FranzVanChopin/ac920-score-digitizer/requirements-board.lock.txt

# Version record from the frozen board Python 3.12 environment.
# ARM64 wheels and Ubuntu system GTK packages are installed separately; see docs/BUILD.md.
antlr4-python3-runtime==4.9.3
certifi==2026.7.22
charset-normalizer==3.5.2
colorlog==6.12.0
flatbuffers==25.12.19
homr==0.7.0
idna==3.20
mido==1.3.3
musicxml==1.4
numpy==2.5.3
omegaconf==2.3.1
onnxruntime==1.30.0
opencv-python-headless==4.14.0.94
packaging==26.3
pillow==12.3.0
pip==25.0.1
protobuf==7.36.2
pyclipper==1.4.0
PyYAML==6.0.3
rapidocr==3.10.0
requests==2.34.2
shapely==2.2.0
six==1.17.0
tqdm==4.70.1
types-Pillow==10.2.0.20240822
typing_extensions==4.16.0
urllib3==2.8.0
verovio==6.3.0
