FranzVanChopin/ac920-score-digitizer/board/recognition/EVIDENCE_20261103.md

# 证据包说明（2026-11-03）

来源：`AC920_Handoff_Evidence_20261103`，对应源码包 `AC920_Source_GitHub_20261102`。
稳定版 **DP_STABLE720_RESPONSE1 / a4_interactive_ui1_light2**，拍摄端与 Ubuntu 均为 720p60。

## 材料去向

| 材料 | 本仓库位置 |
|---|---|
| 综合 / 实现 timing、utilization、DRC 原报告 | `build/reports/` |
| 2026-10-29 原始报告（未改动） | `build/reports/original_20261029/` |
| 报告导出执行日志（含一次可复核的纠错） | `build/report_export_logs/` |
| 报告身份：工具、时间、检查点/位流/XSA/BOOT 哈希、时序与资源摘要 | `build/reports/REPORT_IDENTITY.json` |
| 本次卡内容回读（只读 FAT） | `board/recognition/card_20261103/` |
| 历史板端识别日志 | `board/recognition/historical/` |
| 机器可读验收摘要 | `board/recognition/VALIDATION_20261103.json` |

## FPGA 报告

用 Vivado 2024.2 从**既有已验收工程与 routed checkpoint 重新导出**，不是重新综合或实现，
位流、XSA、BOOT 与 43 份固件源码均与稳定版构建记录核对过。

| 阶段 | WNS | TNS | WHS | THS | WPWS |
|---|---:|---:|---:|---:|---:|
| synthesis | 1.871 | 0 | −0.447 | −1014.791 | −0.832 |
| implementation | **0.817** | **0** | **0.011** | **0** | **0.145** |

实现后资源：LUT 10,825（12.32%）、寄存器 16,272（9.26%）、BRAM Tile 22.5（17.58%）、URAM 8（16.67%）、DSP 8（1.10%）。
实现 DRC：0 Error、0 Critical Warning，保留 **8 条 Warning**（DPOP-4×4、REQP-1934×1、REQP-1935×2、RTSTAT-10×1）。

**综合阶段尚未布局布线**，其 hold / pulse-width 负裕量不代表实现结果；
验收只看 implementation 报告，两个阶段不可混用。详见 `build/reports/README.md`。

该报告对应**纯 DP 采集工程** `camera_capture_wrapper`（即当前部署设计），不是历史 HDMI 分支。
`REPORT_IDENTITY.json` 里的 checkpoint 路径仍记为导出当时的 `lab/...`；重组后实际位于
`board/camera_onecard_20261029/`。证据内容本身未改写。

## 识别日志

历史日志来自真实开发板执行，含 stable720 第 0 首约 **40.9 s** 的识别、逐阶段耗时与 v16 集成检查。
本次只是**读取回**卡内 FAT，没有触发新识别、没有播放音频、没有改写启动文件。

第 01 首共 **6 页**，逐页小节数为 **17 / 14 / 11 / 6 / 10 / 13**，合计 **71 小节**；
第 00 首 1 页 17 小节。这组数字解释了 `data/samples/result/01.musicxml` 为什么是整首 71 小节，
而样张只有第 1 页（17 小节）。

ext4 内的 service journal 因当时 Windows 进程无原始设备读权限而未取回，详见
`board/recognition/card_20261103/README.md`。

## 未并入的材料

原证据包的 `MANIFEST.json` 列了 **121 项**，实际只交付 **111 项**，缺 10 项；
其自带的 `verify_manifest.py` 因此会失败。本仓库不收录该清单与校验脚本，
统一由根目录 `PACKAGE_MANIFEST.json` 校验。

**这些缺口已由 2026-11-03 的脱敏补充包替代**（见 `REPO_LAYOUT.md` 第 8 节）：
原始聊天摘录、`EXPORT_SCOPE.json`、需求截图与 `README_给组长.md` 按脱敏要求**不再分发**，
改以 `collaboration/` 下的 3 份抽象说明承载分工与纠错方法。
旧清单中缺失的具体项（仅作记录）：`collaboration/` 7 个文件（Codex 三份摘录、
`Claude_visible_messages.md/.json`、`AI_WORKFLOW_AND_CORRECTIONS.md`、`EXPORT_SCOPE.json`）、
`requirements/request_1.png`、`requirements/request_2.png`、`README_给组长.md`。

另：

- 证据包根目录的 3 张 `Screenshot 2026-11-03 *.png` 不在其清单内，且与清单所列
  `requirements/*.png` 不是同一批文件；属需求沟通截图，未并入公开仓库。
- `docs/CAPTURE_INTERFACE.md` 与本仓库 `report/CAPTURE_INTERFACE.md` 字节相同，未重复收录。
- `board/recognition/card_20261103/Outputs/01.musicxml`（CRLF）与
  `data/samples/result/01.musicxml`（LF）**内容相同、字节不同**：前者是脱敏重导出的卡回读快照，
  后者供复现比对。此前记录的「同一 SHA-256」在重导出后不再成立，以本段为准。

完整性与逐文件身份见 `docs/EVIDENCE_PROVENANCE.json`（记录 `source_sha256` 与 `published_sha256`）。
