FranzVanChopin/ac920-score-digitizer/src/omr/docs/lens_compare_README.md

# 镜头与光圈对比（2026-10-29）

样片：`Image/Compare`，同一张乐谱（《月光》第三乐章第 1 页，第 1–21 小节，7 行谱），IMX477 全分辨率灰度 4056×2868（已裁成 A4 比例），增益 0。

| 照片 | 镜头 | 光圈 | 曝光 |
|---|---|---|---|
| 1 | 8 mm | F2.8 | 92 ms |
| 2 | 8 mm | F4 | 222 ms |
| 3 | 12 mm | F2.4 | 63 ms |
| 4 | 12 mm | F4 | 172 ms |
| 5 | 16 mm | F2.4 | 59 ms |
| 6 | 16 mm | F4 | 185 ms |

照片是横向的，先逆时针旋转 90° 摆正后再评估（识别端不会自动旋转）。

## 结论

1. **光圈用 F2.4–F2.8，不要收到 F4。** 这个距离下，F2.4 的景深已有约 35 mm，平放的纸用不了这么多。收到 F4 后，曝光时间变为 2–2.4 倍，衍射也让中心变软，识别反而变差（8 mm：67–70% → 63–65%；16 mm：65–67% → 51–56%）。
2. **镜头选 8 mm F2.8 或 16 mm F2.4，两者识别结果持平，按支架高度选择：**
   - 8 mm 镜头离纸约 39 cm，装置紧凑，适合桌面演示，**推荐**。它有轻微桶形畸变（谱线弯曲 ≤ 0.1 个谱线间距），对识别没有影响；广角对相机倾斜更敏感，安装时要让镜头尽量正对纸面。
   - 16 mm 镜头离纸约 78 cm。它的谱线最平直，四角清晰度也最均匀。如果已有足够高的支架，它的画质最干净。
3. **不用 12 mm 镜头。** 照片 3 中心失焦，识别失败（只找到 18 个小节）。照片 4 收到 F4 后，左上和右上角仍明显发虚（边缘宽度 6.3–6.7 px），是三支镜头里最差的，可能是镜头本身或安装倾斜的问题。
4. **必须用全分辨率，不能用 2×2 合并。** 这份乐谱字号小，印刷谱线间距只有约 1.3 mm，合并后只剩 9 px。六张合并图的小节数全部识别错误（16–20 个，应为 21 个），按评分规则都记 0 分。全分辨率下是 18 px，可以正常识别。
5. **照明不均匀，要改善。** 六张照片都是上亮下暗：纸面灰度从顶部约 220 降到底部约 155。各镜头的情况一样，所以这是光源造成的，不是镜头暗角。建议两侧各放一个光源，或加柔光，使整页纸面都落在 190–235。
6. **取景太紧。** 纸张左右两边刚好在画面边缘，谱表距画面左右边只有约 120–165 px（约 7–9 个谱线间距）。纸放偏 1 cm，谱表就会被切掉。建议升高镜头约 5%，让整张纸带边距入画；谱线间距会降到约 17 px，仍在可用范围。

## 测量结果

### 清晰度（`measure_sharpness.py`，摆正后，边缘宽度 10–90%，单位 px）

每格的两个数分别是横线（谱线）和竖线（符干、小节线）的边缘宽度。

| 照片 | 中心 | 四角最差 | 墨迹 / 纸面灰度 |
|---|---|---|---|
| 1 · 8 mm F2.8 | 3.5 / 3.1 | 6.0（右上竖线） | 87 / 225 |
| 2 · 8 mm F4 | 3.6 / 3.5 | 5.8（左下横线） | 87 / 217 |
| 3 · 12 mm F2.4 | **6.5 / 8.0** | 6.1 | 97 / 215 |
| 4 · 12 mm F4 | 3.6 / 3.5 | **6.7**（右上竖线） | 90 / 217 |
| 5 · 16 mm F2.4 | 3.7 / 3.6 | 5.1 | 86 / 216 |
| 6 · 16 mm F4 | 4.2 / 3.8 | 6.2（右下横线） | 89 / 216 |

参照：PDF 直接渲染的图约为 2.3 px。按模拟实验（`../CAPTURE_INTERFACE.md` 第 3 节），边缘宽度约 5 px 以内准确率基本不变，7 px 时明显下降。

### 识别（v16 流程，桌面）

真值：PDMX 中同一乐章的两份公开转谱（cand4、cand1），取第 1–21 小节，用 camera67 评分器统计完全正确的音符。小节数不对时记 0 分。

| 输入 | 小节 | 谱表 | 正确音符（cand4） | 正确音符（cand1） |
|---|---:|---:|---:|---:|
| PDF 渲染 300 dpi | 21 | 14 | 302/511（59.1%） | 289/511（56.6%） |
| PDF 渲染 400 dpi | 21 | 14 | 305/511（59.7%） | 288/511（56.4%） |
| 1 · 8 mm F2.8 | 21 | 14 | **356（69.7%）** | 341（66.7%） |
| 2 · 8 mm F4 | 21 | 14 | 330（64.6%） | 324（63.4%） |
| 3 · 12 mm F2.4 | **18** | 15 | 0 | 0 |
| 4 · 12 mm F4 | 21 | 14 | 295（57.7%） | 288（56.4%） |
| 5 · 16 mm F2.4 | 21 | 14 | 332（65.0%） | **342（66.9%）** |
| 6 · 16 mm F4 | 21 | 13（漏一行谱表） | 262（51.3%） | 284（55.6%） |
| 1–6 的 2×2 合并图 | 16–20 | 13–15 | 0 | 0 |

解读这张表要注意以下几点：
- **绝对值偏低，不是相机造成的。** PDF 渲染图本身也只有 56–60%。原因有两个：公开转谱与这份 PDF 的记谱有出入（休止符 0/8 对不上），而且这页是密集的十六分音符琶音。实拍图没有比渲染图差，说明相机这一环已经不是瓶颈。
- **单页结果波动大。** 同一份 PDF，300 dpi 与 400 dpi 两次识别只有约一半音符完全一致，所以 5% 以内的差别不能用来排序。能下结论的只有几处明显差距：12 mm F2.4 失败、F4 普遍更差、合并模式全部失败。

### 畸变与倾斜（`staff_bow.py`，由识别出的谱线折线拟合二次曲线）

| 照片 | 谱线最大弯曲 | 从上到下的倾角变化 |
|---|---|---|
| PDF 渲染（测量噪声） | 0.07 个谱线间距 | 0.05° |
| 1 · 8 mm F2.8 | 0.10（上凸下凹，轻微桶形） | 0.37° |
| 2 · 8 mm F4 | 0.11 | 0.38° |
| 4 · 12 mm F4 | 0.16 | 0.24° |
| 5 · 16 mm F2.4 | 0.05 | 0.30° |
| 6 · 16 mm F4 | 0.08 | 0.24° |

各镜头的畸变都可以忽略。倾角从上到下有变化，说明谱线不完全平行，即相机没有完全正对纸面（梯形）。这种变化在 8 mm 上最大，因为视角越广，同样的倾斜造成的梯形越明显。换算下来，左右两边的谱线距离相差约 16 px（0.5%），识别能容忍。

### 几何计算

- 放大倍率：谱表长度在照片中约 2540 px（3.94 mm 传感器），实际约 189 mm，倍率约 1/48。
- 工作距离（物距）：8 mm 约 39 cm，12 mm 约 59 cm，16 mm 约 78 cm。
- 景深（弥散圆取 2 像素，即 3.1 µm）：在同样取景下与焦距无关。F2.4 约 35 mm，F2.8 约 41 mm，F4 约 58 mm。
- 衍射（艾里斑直径）：F2.4 约 2.1 px，F2.8 约 2.4 px，F4 约 3.5 px。

## 复现

```
python run_photos.py <摆正的照片...>          # v16 流程，结果写入 lab/tmp/cam2_<名字>/
python score_vs.py <参照.musicxml 或 运行名> <运行名...>
python staff_bow.py <运行名...>
python -I render_pdf.py <pdf> <输出目录> 300 400  # PDF 第 1 页渲染（下载的文件，用 -I 运行）
```

摆正后的照片在 `lab/tmp/compare_upright/`，PDMX 转谱在 `lab/tmp/compare_ref/pdmx/`（cand1/2/4 为同一乐章的不同转谱，cand2 与 cand4 前 21 小节相同；cand3 调号不对，未用）。
