FranzVanChopin/ac920-score-digitizer/board/recognition/card_20261103/Outputs/README.txt

曲谱保存在此文件夹：SS.musicxml（SS 为曲目编号）。
可以直接复制到电脑，或删除不需要的 .musicxml。下次进入 Ubuntu 时，曲库同步并清理对应本地识别副本和播放缓存。
删除照片与删除曲谱互相独立；要完全删除一个采集批次，另行删除 Image/Grey/Binary/Meta 中对应 SS-PP 文件。
album.json、last_run.log 是识别辅助记录，不是曲谱文件。请勿删除卡内的启动文件及 OneCard/linux 文件夹。
