FranzVanChopin/ac920-score-digitizer/report/CAPTURE_INTERFACE.md

# 采集端与识别端的图像接口（更新至 2026-11-01）

## 当前有效接口：Light2 图像协议 / 原生 DP 显示与播放

用户的新 DP 转接线到位后，已备份 Audio2 并恢复 HDMI 改造前的 `a4_interactive_ui1_light2`，采集工作目录为 `lab/camera_interactive_20261030`。Ubuntu 使用 DP 图形界面和 DP ALSA 音频设备，HDMI 显示服务已禁用。采集 BOOT、设备树及 PL 与原 DP 快照一致；Linux boot.scr 已修正 AXI 接口位宽并固定早期显示模式。2026-11-01 早间摄像头已接回，正常往返中读取到 0x0477、恢复相机 READY，DP 无翻帧超时。原照片及元数据 21 份、采集暂存文件 1 份校验不变。本节定义现行交接规则；后文保留的旧固件行为不作为当前接口。

当前恢复记录见 `reports/DP_RESTORE_20261031.md`，备份位于 `outputs/backups/before_dp_restore_20261031_233948`。2026-10-31 的 HDMI 试验另见 `reports/HDMI_OVERNIGHT_20261031.md`。保存尺寸、裁切、方向、SS-PP 编号、Image/Grey/Meta 提交和识别 v16 均不变。

2026-11-01 早间稳定版：`/opt/ac920-panel` 指向 **`/opt/ac920-panel-responsive1`**。已按用户要求撤回 1080p，内核早期显示、Xorg、Mutter 和应用统一为 **1280×720、60 Hz、1× 缩放**，与拍照侧显示一致。窗口设置 `_NET_WM_BYPASS_COMPOSITOR=2`，请求保留全屏合成；用户已确认识别时没有撕裂重叠、往返不再反复断信号、S2 快多了。切换仍是整机重启，会有短暂黑屏和启动等待，不能承诺全程无黑屏。

板载按键由控制器独占，内核已消抖，软件逐个处理按下/松开事件；短按仍在松开后执行，长按阈值仍为 1.5 秒。GUI 用后台等待状态通知代替在绘制线程轮询套接字。组件计时不代表屏幕实物端到端延迟。记录见 `lab/display_stability_20261101/`、`lab/key_response_20261101/`。

### 成品曲谱以 FAT 为准

成品位于 FAT 分区 **`Outputs/SS.musicxml`**，Windows 插卡后可直接复制或删除。第一次更新时把有效的 ext4 旧曲谱补入 FAT，保留已有 FAT 文件；之后曲库扫描和播放只读取 FAT 曲谱，不再从 ext4 副本补回被删除的项目。

删除 FAT 中的某首 `.musicxml` 后，下次进入 Ubuntu/启动控制器时，清理该曲目的 ext4 合并 XML、逐页识别中间目录、旋转工作图和排版/音频缓存，并清除本地完成记录。仍保留原照片，因此同编号若还有已提交的 Grey/Meta，可再次手动识别。删除照片与删除成品曲谱独立；完全删除一批拍摄材料需另行删除 `Image/Grey/Meta` 中相应 `SS-PP` 文件。备份归档不会随日常删除而抹除。

识别过程中仍在 ext4 工作以避免大量 FAT 小文件写入；成功后原子导出 `Outputs/SS.musicxml`。本地 `fat-library.json` 只记录曲谱编号，用于离线删卡后的缓存清理；身份标记缺失或清理索引损坏时拒绝清理。板上用空闲编号 99 验证了“导出→删除 FAT XML→清理缓存→不复活”，原曲谱和照片哈希不变。

早间修复了这一清理路径的权限回归：root 原子重写的 `results/album.json` 必须恢复为 results 目录所有者（识别用户）的私有文件，不能保留 root:root/0600。现有错误权限也会在控制器启动时修正。第 0 首已实际完成识别并导出 FAT `Outputs/00.musicxml`，约 40.9 秒；再用测试编号 99 重现删谱和重写，识别用户仍可读取，真实曲谱不变。

### 打开、播放和自动验证

长按 S2 浏览/播放时先发布谱面，再准备当前速度的 WAV；其余速度低优先级后台补齐。有效的谱面和音频直接复用；新前台操作会取消后台准备，S3 卸载 FAT 前等待后台输入释放。仍使用原 MIDI、FluidR3 GM、48 kHz stereo16、混响和力度规则，不启用实时合成试验程序。真实第 0 首的隔离静音测试约 2.0 秒准备好谱面、7.8 秒完成当前速度资产；暖缓存控制器准备约 3.6 ms，不含 GUI、声卡和显示器延迟。

**用户要求不要突然播放。自动验证默认静音；需要实际扬声器试听时，先明确告知并等用户准备好。** 实时合成试验仅留在 `lab/key_response_20261101/experiments/`，未部署。用户手动在曲库长按 S2 的打开并播放功能保留。最终版本未主动出声试听，不把静音文件生成当作实际扬声器或同步验收。

2026-10-30 识别端已切换到正式 v16 目录 `/home/fpga/claude-release-v16-20261030`，不再从开发目录运行。正式发布 ZIP 的 SHA256 为 `84845713f7f098d3bdf0c0d7f804dab582eb80489c244427048125a608959258`；板上重新核对 MANIFEST 63/63 和 ARM64 库 4/4，并从正式目录再生成阶段进度引擎。仅改变配置的 `recognizer`，保留 `ccw`、Python、app 和采集固件。迁移与回退证据见 `lab/score_studio_v16_20261030/`，新实拍及实际播放验收仍单独记录。

正式目录接入后，独立参考页通过实际 Score Studio 入口：六阶段进度齐全、`clef_ratio=1.0`、`orientation_suspect=false`、输出与正式包板测参考一致；合成 XML 含 key/clef/beam/accidental，21/21 小节发声音符不变，并完成带调号和符杠的离屏谱面及四档音频准备。此测试不向真实拍摄相册或 FAT Outputs 写入参考结果，不代替新实拍与实际听音。

### 图像、方向与文件提交

| 项目 | 当前约定 |
|---|---|
| 采集源与裁切 | 拍照源 4056×3040 RAW12；固定取 `(x=0,y=86,w=4056,h=2868)`，不依赖纸张检测，不缩放 |
| 彩照 | `Image/SS-PP.bmp`，24 bit，4056×2868，34,897,878 字节 |
| 灰度 | `Grey/SS-PP.bmp`，8 bit，4056×2868，11,633,686 字节；从实际保存彩照逐像素转换 |
| 参数与提交 | `Meta/SS-PP.json` 记录版本、曲目/页码、曝光、增益、WB、裁切和对焦等；最后提交，`complete=true` 才加入识别相册 |
| 编号 | SS 为 00～99 首、PP 为 00～99 页；短按拍照后页码递增，长按 S1 下一首并归零；重启续接，避免覆盖 |
| 采集处理 | 保留传感器白平衡、PS CCM、低模拟增益策略与色度降噪；不保存 Binary、不做 CLAHE 或预先二值化 |
| 原始方向 | 预览和 Grey 均不旋转、不镜像；**乐谱顶端必须朝原图及预览右侧** |
| 识别转正 | 配置固定 `rotate=ccw`，逆时针转 90°；不启用自动方向判断。随后由识别端裁纸、缩放至宽 1920、CLAHE、网络内局部二值化 |

普通拍摄预览右侧显示蓝条、白色 `PAGE TOP` 右箭头卡片，左栏显示 `Top edge: right`。这些标记仅写显示缓冲，不进入保存的 Image/Grey；对焦模式隐藏方向标记。传感器预览为 2028×1520，固定 A4 预览为 2028×1434。拍照侧原生 DP 为 1280×720、60 Hz，已通过新转接线完成链路训练。Ubuntu 按屏幕 EDID 自动选模式；本次读取到 3840×2160、30 Hz 输入模式，界面按窗口尺寸绘制。这是输入协商结果，不代表显示面板物理分辨率。保存图像不缩小。

### 单卡启动、人工操作与结果

当前使用同一张 512 GB 卡：16 GiB FAT32 保存启动文件和图像，64 GiB ext4 保存 Ubuntu、识别程序、结果与播放缓存，其余空间尚未分区。FAT 根目录 `BOOT.BIN` 为采集端、`BOOT0001.BIN` 为 Ubuntu，内核/设备树/比特流置于 `linux/`。S3 通过同步、卸载、校验和 MultiBoot 槽位切换环境，两个运行环境分时使用 FAT。

| 操作 | 采集侧 | Linux 侧 |
|---|---|---|
| S1 短按 | 同帧保存 Image/Grey/Meta | 乐谱库循环四档调速；识别界面无识别动作 |
| S1 长按约 1.5 s | 下一首，页码归零 | 切换识别界面/乐谱库 |
| S2 短按 | 对焦中循环五个区域 | 循环选择曲目 |
| S2 长按约 1.5 s | 进入/退出对焦 | 识别界面启动选定曲目；乐谱库打开/播放/重播 |
| S3 短按 | 安全进入 Ubuntu | 安全返回采集；忙时等当前任务完成 |

Ubuntu 自动登录并启动界面。`ac920-panel.service` 启动只列出批次，用户长按 S2 才调用 album `--songs SS`，只处理选定一首；六个实际识别阶段驱动逐页进度，成功提交后才计 100%。结果先写 ext4 `/var/lib/ac920-onecard/results`，再受控导出 FAT `Outputs/SS.musicxml`、相册状态和最近日志。成功或失败均留在 Linux，S3 才返回；原 `ac920-onecard` 自动识别/自动返回服务已禁用。

Light2 控制器处理 SIGTERM/SIGINT，终止子进程、等待工作线程退出后同步卸载 FAT。已在真实 systemd 上完成连续三次重启和 stop 后无挂载残留的验证。

### 相册方向诊断与记谱

已换入 Claude 新版 `omr_album.py`、`merge_pages.py`、`engrave.py` 原文件，并通过 `patch_progress.py` 重新生成带阶段事件的引擎入口。缓存同时核对 Grey 哈希和旋转方向；每页记录 `rotate_used`、`clef_ratio`、`orientation_suspect`。可疑页在识别界面提示：

> 这一页可能放反了：请把乐谱上方朝向拍摄界面的箭头（右侧）重拍

旧三张实拍顶端朝左，与当前固定 ccw 约定相反，需重新拍摄。倒置识别结果已归档至 `/var/lib/ac920-onecard/results.upside-down-20261030`，升级前备份亦保留原导出文件；当前界面不将未满足当前照片哈希和方向的旧结果列为已完成。

相册合并使用谱头记录生成记谱字段。浏览层只在显示副本补缺失类型等信息，保留已有 clef、key、beam，不改原 XML 音高和时长。采集端未因这次更新加入拍照延时，也未改变曝光策略。

### 排版、音频资产与历史验证边界

Linux 保持浅色卡片界面；播放时使用全屏主要区域显示 Verovio SVG，包含小节的 `renderToTimemap` 驱动翻页和高亮，反复段映射回原谱。音频资产为 FluidSynth 2.2.5 + FluidR3 GM 钢琴采样、48 kHz 双声道 16 bit、混响开启；旋律/伴奏及强拍有简单力度区分。S1 短按循环 0.75/1/1.25/1.5 倍，切速从曲首重播；通过改变 MIDI 速度生成四档 WAV，音高不变，页面和高亮共用基础时间轴。当前恢复原 DP 播放器，通过 `aplay` 显式选择 DP ALSA 声卡；Audio2 的 FPGA PCM FIFO 分支不启用，已保留在源码及备份中。

| 层级 | 截至 2026-10-30 的证据 |
|---|---|
| 构建与自动测试 | A53 严格编译通过；29 项主机用例中 28 项通过，1 项 POSIX SIGTERM 用例已在板上通过；板上 4 项控制器用例通过 |
| 实际部署与服务 | 卡容量/身份、BOOT/清单/配置及源文件哈希一致；连续三次重启、stop 卸载、四档调速 API 通过；单份 GUI 运行 |
| 启动 | Linux → Light2 摄像端 → Linux 通过，读取 IMX477 0x0477、恢复 READY、编号续接 01-01；本轮未拍照 |
| 排版与音频文件 | 既有 512 音符、21 小节 XML 样本排为 4 页，基础 MIDI 约 43.31 s；首次排版及生成四档 WAV 约 30.31 s，无采样削波；方向警告和高亮已离屏绘制 |
| 仍待实物验收 | 纸顶朝右的新照片、谱号检出比例与音符准确率、实体按键全流程、720p DP 实屏、实际听音及同步 |

排版样本不是本轮正确方向的新识别结果；成功输出 WAV 不代表音符识别正确。原 v16 的 29.9 s/页与 camera67 的 94.35% 属于原算法基准，不能作为当前整机端到端时间或新实拍准确率。

以上 2026-10-30 历史证据：`lab/camera_interactive_20261030/validation/review_acceptance.json`、`review_installed/`、`review_boot/`、`review_preflight/`。早期 DP2 的实体按键和原生 DP 验证见 `lab/camera_onecard_20261029/validation/board_acceptance_result.json`。当前恢复的 DP 发布包为 `release/AC920_IMX477_ScoreStudio_UI1_Light2_20261030.zip`；HDMI 两版归档仍保留为 `release/AC920_IMX477_HDMI_Video1_20261031.zip` 与 `release/AC920_IMX477_HDMI_Audio2_Experimental_20261031.zip`。

## 历史输入质量与采集分析（2026-10-28）

以下保留原输入质量要求、模拟实验和旧样片分析。当前固定 A4 裁切、SS-PP 命名、方向转正、保存内容及单卡控制，以前述 Light2 接口为准。

本文对象：Codex 的采集固件 `software/camera_capture`，以及识别软件（`run_page.py` / `run_serve.sh`）。

依据：
- 2026-10-28 的样片：`Image/000004*.bmp`（全分辨率），`Image/04_sensor_bin2_*.bmp`（IMX477 2×2 合并）；
- 模拟实验：`sim_capture.py`；
- 清晰度测量：`measure_sharpness.py`。

## 1. 结论：识别端要什么样的图像

| 项目 | 规定 | 原因 |
|---|---|---|
| 分辨率 | **全分辨率 4056×3040，不合并像素** | 镜头稍模糊时更稳（见第 3 节）；合并模式只作备选 |
| 格式 | **8 位灰度，无损**（PNG，或 8 位灰度 BMP） | 识别端本来就用这种灰度（OpenCV BGR→GRAY，即 BT.601）；样片 `000004_Grey.bmp` 与之逐点一致，数据量只有彩色的 1/3 |
| 采集端处理 | **可以裁到纸张（推荐，见第 1.1 节）；不做二值化、不做 CLAHE、不缩放** | 识别端会自行缩放到宽 1920、做 CLAHE，网络内部再二值化，这套流程是验证过的。预先二值化会丢失信息（第 3 节）；预先做 CLAHE 会被做两遍 |
| 方向 | **进入单页识别入口时乐谱正立**：谱线水平，页面顶端朝上 | 此为历史单页入口要求；当前采集保留原方向，由相册固定 ccw 转正，纸顶须朝原图右侧 |
| 取景 | **整页入画**，纸张四边都在画面内，纸张约占画面的 85–95% | 拍不到的内容，裁切也补不回来；谱表被切断时，分组和小节数都会出错 |
| 尺度 | 照片中谱线间距 **20–30 像素**（整页 A4 全分辨率竖拍约 23 像素） | 缩放到宽 1920 后约 15–20 像素，正是网络和规则的工作范围。近拍图约 60 像素，超出范围，只识别出约 12 个音 |
| 清晰度 | 全分辨率下五个区域的边缘宽度（10–90%）**都 ≤ 5 像素**，理想 ≤ 4 像素 | 模拟显示，约 5 像素以内准确率基本不变，7 像素时降到约 74%（第 3 节） |
| 曝光 | 纸面灰度约 190–235，墨迹 ≤ 90，不截顶 | 现在的样片纸面 206、墨迹 69，合格 |
| 写文件 | 先写临时文件，写完再改名为最终文件名 | 避免识别端读到写了一半的文件。现有固件的 `PHOTO.TMP` 正是这样做的 |

### 1.1 采集端裁切到 A4（推荐）

测试集里，camera67 的 65 页和开发板测试页都是纸张撑满画面、没有背景的图像。识别端的自动裁切在这 66 页上全部保留了整张图，所以识别流程本来就是在"已裁到纸张"的图像上验证的。采集端把桌面裁掉不但可以，还能缩小文件，并避免浅色桌面或阴影干扰识别端的自动裁切。

裁切要满足以下条件：
- **只裁到纸张边缘或略向外：** 可以留纸张边缘外 1–2% 的余量，绝不能裁进印刷区域。纸张自带的白边要保留。
- **最好做透视校正：** 由纸张四个角点做单应变换，拉正为矩形，谱线会更平直；只做轴对齐的矩形裁切也可以。
- **保持原始尺度：** 不缩小，整页宽度约 2400–2900 像素。插值用双线性或双三次。
- **找不准纸张时宁可不裁：** 四角检测不可靠时，输出未裁切的整幅图像，并在文件名或日志里标明。不要用固定位置去硬裁，一旦裁进内容，损失比留着桌面大得多。
- **方向和格式不变：** 裁切后乐谱仍要正立，仍是 8 位灰度、无损格式。

如果用支架把 A4 纸放在固定位置，也可以用一个固定的裁切框，稍大于纸张即可，这样最简单可靠。

**交接方式：** 识别端使用常驻流水线：

```
run_page.py --serve --pipeline   （或 run_serve.sh）
```

每有一张新照片，就向它的标准输入写一行：

```
<照片绝对路径>\t<新的输出目录>
```

每页的结果是输出目录下的 `page.musicxml` 和 `report.json`；程序在标准输出上每页打印一行 JSON。连续拍多页时，下一页的网络推理会和上一页的后续计算重叠。

2026-10-28 此接口提出时，采集固件与 Ubuntu 识别端尚待整合；目前已采用前述单卡分时启动、SD 文件交接方案，保留该阶段说明供追溯。

## 2. 样片检查结果（`measure_sharpness.py`）

| 照片 | 谱线间距 | 边缘宽度（中心 / 四角） | 说明 |
|---|---|---|---|
| `000004.bmp`（全分辨率） | 59 px | 9.5 / 3.9–8.8 px | 近拍，只拍到局部页面；只有一角较清楚，可能是景深浅（约 ±3 mm）加纸面不平 |
| `04_sensor_bin2_color.bmp`（合并） | 30 px | 4.7 / 4.5–6.2 px | 同一画面；换算到纸面上的模糊程度与全分辨率相同 |
| 开发板测试页（电子版） | 24 px | 2.1 / 1.5–2.4 px | 理想参照 |

**用识别流程直接跑这几张近拍图：**
- 全分辨率灰度：找到 3 行谱、12 个音；
- 合并模式灰度：11 个音；
- 二值图：只有 6 个音。

画面里大约有 60 个音。原因是尺度过大，谱表也被画面切断了。这不是对准焦以后的真实水平，需要按第 1 节的要求拍整页，再评估一次。

**画面中的问题：**
- **细线锯齿：** 全分辨率图里，谱线和符干呈"麻绳状"锯齿，这是去马赛克在高对比细线上产生的拉链纹；合并模式下较轻。缩放到识别尺度后会部分平均掉，影响多大，要等整页实拍才能确定。建议 Codex 核对 `v_demosaic` 的 Bayer 相位和算法设置。
- **底色偏蓝：** 白平衡的问题，对灰度识别几乎没有影响。

## 3. 模拟实验：分辨率、清晰度与二值化（`sim_capture.py`）

方法：
1. 把开发板测试页（谱线间距 24 px，相当于整页入画时的全分辨率照片）调成相机的灰度范围（纸 210、墨 70）；
2. 加上不同程度的高斯镜头模糊 σ（单位是全分辨率像素），以及噪声；
3. 分别按全分辨率、2×2 合并（平均）、二值化（局部均值）送进 v16 识别流程，统计正确音符数（共 263 个）。

| σ（px） | 边缘宽度（全分辨率 / 合并） | 全分辨率灰度 | 合并灰度 | 全分辨率二值 | 合并二值 |
|---:|---|---:|---:|---:|---:|
| 0 | 2.1 / 2.0 | 262 | 263 | 261 | 251 |
| 1.5 | 3.3 / 2.3 | 256 | 260 | 255 | 228 |
| 2.5 | 5.1 / 2.9 | 261 | 258 | 256 | 232 |
| 3.5 | 7.1 / 4.4 | 195 | 168 | 24 | 18 |

- **灰度好于二值：** 每一档都是灰度更好；模糊加重时，二值输入会彻底失败。
- **全分辨率与合并：** 清晰时两者差不多（相差 ±4 个音，属于单页的正常波动）；变模糊后全分辨率更稳（195 对 168）。所以默认用全分辨率。合并模式数据量只有 1/4、噪声更低，可以留作弱光或快速预览的备选。
- **清晰度门槛：** 全分辨率边缘宽度约 5 px 以内，准确率基本不受影响；到 7 px 就降到约 74%。现在的近拍样片大部分区域是 7–9.5 px。如果整页距离下镜头和对焦仍是这个水平，就不够用，需要对准焦、收光圈到 F4–F5.6，必要时换镜头。

## 4. 当时的后续建议（2026-10-28）

本节为旧样片条件下的建议，不表示 Light2 尚未实现集成或当前需要改存 PNG。现行待验收项以前述“DP 排版、音频与验证边界”为准。

1. **按第 1 节拍整页样片：**
   - 25 mm 镜头竖拍时，工作距离约 1.3 m，或换短焦镜头；
   - 用对焦辅助对焦，收光圈到 F4–F5.6；
   - 输出全分辨率 8 位灰度 PNG；可按第 1.1 节裁到纸张。
2. **检查与评估：** 用 `python measure_sharpness.py <照片>` 检查谱线间距、边缘宽度和是否整页入画，再交给识别流程评估。
3. **可选：** 采集端直接计算同一种边缘宽度，拍照时就提示是否合格（对焦辅助的需求说明里已有这项计算）。
