FranzVanChopin/ac920-score-digitizer/collaboration/parallel_working_lines_and_contribution.md

# 并行工作线与贡献

下表合并说明与本项目有关的多个 Project/并行会话，不涉及其他无关项目。会话名称用于说明工作来源，不附会话编号或聊天原文。

| 工作线 | 相关来源 | 实际贡献 | 状态和边界 |
|---|---|---|---|
| 识别主链与加速 | Claude 识别开发、Codex“实现FPGA乐谱识别与播放” | 识别/关系/节奏解码探索，正式共享网络路径，C++ 热点实现，常驻与跨页处理 | 当前 v16 路径与早期实验分别记录，不能汇总不同基准的准确率 |
| 符号、声部与关系优化 | “改进乐谱符号识别流程” | 谱表恢复、关系层热点、局部约束、事件复用、独立测试集及 ABBA 比较 | 有收益的候选仍需保护已有正确事件；未过门候选未并入默认入口 |
| 独立作品复现 | “识别C大调圆舞曲乐谱”等 | 电子谱转图、独立识别、结构/渲染检查、与参考结果比较 | 单作品结果不代表新实拍或全部数据集表现 |
| 相机与 FPGA 采集 | “查找适配开发板的低畸变摄像头”、实物联调 | IMX477、CSI/ISP/VDMA、写卡、曝光与白平衡、对焦辅助、按键 | 与当前稳定固件及工程身份绑定 |
| 输入质量实验 | Claude 对焦/镜头实验、“二值化查看两张 BMP 图像”等 | 对焦量化、去马赛克排查、分辨率/传感器合并/数字缩放/二值化对照 | 检查实际识别效果，不能只按视觉清晰度选择预处理 |
| 单卡系统与用户操作 | 联调工作线 | FAT/ext4 分时交接、提交标记、曲库删除语义、720p 显示、低延迟按键与播放准备 | 保留重启黑屏和首次资产准备等待等实际边界 |
| 原理动画与成片 | “乐谱识别项目宣传片制造”、Claude 宣传规划 | 从真实图像和计算结果生成 Blender 流程动画，表现 PS 多核、C++ 和 SD 协同；AE 字幕/高亮及节拍对齐 | 动画用于解释，时长不是推理耗时；实机录屏单独标注 |
| 开场与素材探索 | “乐谱识别项目宣传片制造 (2)”、Claude 提示词规划 | AI 视频候选探索、真实谱页开场、长度与可读性迭代 | 尝试方案与最终采用素材分别说明 |
| 实物架构与演示语言 | “乐谱识别项目宣传片制造 (3)” | 模块定格标注、局部强调、多画面布局等演示设计 | 辅助讲解，不替换系统界面与测试结果 |

复用成果主要是接口模板、定位步骤、回归方法、素材来源约束和只读校验脚本；不是对特定人物、设备或聊天的依赖。
