FranzVanChopin/ac920-score-digitizer/skill/multi-project-handoff/assets/handoff.md

# 工作线交接模板

| 工作线 | 输入/基线 | 产物 | 验证条件与证据 | 当前状态 | 不确定性/下一步 |
|---|---|---|---|---|---|
| 填写 | 填写 | 填写 | 填写 | 部署/候选/试验/示意 | 填写 |

汇总时只保留目标、贡献、接口、测试条件、决策和边界。原始聊天、个人操作细节、身份和凭据不进入公开交接。
