FranzVanChopin/ac920-score-digitizer/skill/multi-project-handoff/assets/interface-contract.md

# 接口合同模板

- 目标与允许修改范围：
- 生产者 / 消费者 / 接口负责人：
- 输入产物与版本：
- 格式、尺寸、坐标/方向、单位与编码：
- 命名、完整性与提交标记：
- 输出、错误状态、重试/回退边界：
- 权威存储、并发访问与删除语义：
- 可执行验证与可观察通过条件：
- 未验证项及消费方下一步：
