FranzVanChopin/ac920-score-digitizer/board/camera_interactive_20261030/software/camera_capture/capture_binary.c

/* SPDX-License-Identifier: MIT */
#include "capture_binary.h"
#include <math.h>
#include <stdlib.h>
#include <string.h>

#define DETECT_MAX 512u
#define DETECT_PIXELS (DETECT_MAX * DETECT_MAX)
#define POINTS_MAX (DETECT_MAX * 2u)
#define CANDIDATES_MAX 32u
#define TILE_MAX 16u

typedef struct { double x, y; } point;
typedef struct {
    point q[4];
    double area, rectangularity, contrast[4], score;
} candidate;
typedef struct {
    uint8_t preview[DETECT_PIXELS], smooth[DETECT_PIXELS];
    uint8_t mask[DETECT_PIXELS], temp[DETECT_PIXELS];
    uint32_t queue[DETECT_PIXELS];
    unsigned row_min[DETECT_MAX], row_max[DETECT_MAX];
    point points[POINTS_MAX], hull[POINTS_MAX * 2u], polygon[POINTS_MAX * 2u];
    candidate candidates[CANDIDATES_MAX];
    uint8_t row_gray[4][CAPTURE_BINARY_MAX_DIMENSION];
    uint32_t horizontal[CAPTURE_BINARY_MAX_DIMENSION];
    uint64_t vertical[CAPTURE_BINARY_MAX_DIMENSION];
    uint32_t columns[CAPTURE_BINARY_MAX_DIMENSION];
    unsigned cubic_x[CAPTURE_BINARY_MAX_DIMENSION][4];
    double cubic_weight[CAPTURE_BINARY_MAX_DIMENSION][4];
    uint8_t tile_lut[TILE_MAX * TILE_MAX][256];
} binary_scratch;
_Static_assert(sizeof(binary_scratch) <= CAPTURE_PAPER_WORKSPACE_BYTES,
               "paper detection workspace is too small");
typedef struct {
    const capture_color *color;
    const uint8_t *source;
    unsigned sw, sh;
    size_t source_stride;
    const capture_binary_config *config;
    capture_binary_result *result;
    binary_scratch *scratch;
    void (*service)(void *);
    void *context;
} run_context;

static void tick(run_context *r) { if (r->service) r->service(r->context); }
static unsigned smaller(unsigned a, unsigned b) { return a < b ? a : b; }
static unsigned larger(unsigned a, unsigned b) { return a > b ? a : b; }
static int clamp_index(int i, unsigned n) { return i < 0 ? 0 : (i >= (int)n ? (int)n - 1 : i); }
static uint8_t byte_round(double v)
{
    if (v <= 0.0) return 0;
    if (v >= 255.0) return 255;
    return (uint8_t)(v + 0.5);
}
static uint8_t corrected_gray(const capture_color *color, const uint8_t *p)
{
    uint8_t bgr[3];
    capture_color_apply_bgr(color, p, bgr);
    /* OpenCV's standard fixed-point BGR -> gray coefficients. */
    return (uint8_t)((1868u*bgr[0] + 9617u*bgr[1] + 4899u*bgr[2] + 8192u) >> 14);
}
static double cross(point a, point b, point c)
{
    return (b.x-a.x)*(c.y-a.y) - (b.y-a.y)*(c.x-a.x);
}
static double distance(point a, point b)
{
    double dx=a.x-b.x, dy=a.y-b.y;
    return sqrt(dx*dx+dy*dy);
}
static double polygon_area(const point *p, unsigned n)
{
    double a=0.0;
    unsigned i;
    for (i=0;i<n;++i) a+=p[i].x*p[(i+1u)%n].y-p[i].y*p[(i+1u)%n].x;
    return fabs(a)*0.5;
}
static int compare_point(const void *va, const void *vb)
{
    const point *a=(const point *)va, *b=(const point *)vb;
    if (a->x < b->x) return -1;
    if (a->x > b->x) return 1;
    return a->y < b->y ? -1 : (a->y > b->y ? 1 : 0);
}
static int compare_byte(const void *a, const void *b)
{ return (int)*(const uint8_t *)a - (int)*(const uint8_t *)b; }

void capture_binary_default_config(capture_binary_config *c)
{
    if (!c) return;
    memset(c,0,sizeof(*c));
    c->target_width=1920u;
    c->clahe_clip_limit=2.0;
    c->clahe_tiles_x=c->clahe_tiles_y=8u;
    c->adaptive_block_size=51u;
    c->adaptive_c=10;
    c->mode=CAPTURE_BINARY_A4;
    c->whiten_outside_paper=1u;
}

int capture_a4_crop(unsigned w,unsigned h,unsigned xywh[4])
{
    unsigned short_edge;
    if(!xywh) return CAPTURE_BINARY_INVALID;
    memset(xywh,0,4u*sizeof(*xywh));
    if(!w || !h || w>CAPTURE_BINARY_MAX_DIMENSION || h>CAPTURE_BINARY_MAX_DIMENSION ||
       (uint64_t)w*h>CAPTURE_BINARY_MAX_PIXELS) return CAPTURE_BINARY_INVALID;
    short_edge=(w*70u+49u)/99u;
    if(!short_edge || short_edge>h) return CAPTURE_BINARY_INVALID;
    xywh[2]=w;xywh[3]=short_edge;
    xywh[0]=0u;xywh[1]=(h-short_edge)/2u;
    return CAPTURE_BINARY_OK;
}

static unsigned histogram_percentile(const unsigned h[256], unsigned count, unsigned percent)
{
    unsigned i,sum=0,goal=(count*percent+99u)/100u;
    for(i=0;i<256u;++i) { sum+=h[i]; if(sum>=goal) return i; }
    return 255u;
}
static unsigned otsu_threshold(const unsigned h[256], unsigned count)
{
    unsigned i,n=0,best=0;
    double all=0.0,sum=0.0,maximum=-1.0;
    for(i=0;i<256u;++i) all+=(double)i*h[i];
    for(i=0;i<255u;++i) {
        double a,b,d,v;
        n+=h[i]; sum+=(double)i*h[i];
        if(!n || n==count) continue;
        a=sum/n; b=(all-sum)/(count-n); d=a-b;
        v=(double)n*(count-n)*d*d;
        if(v>maximum) { maximum=v; best=i; }
    }
    return best;
}

static void make_preview(run_context *r, unsigned pw, unsigned ph)
{
    unsigned x,y;
    binary_scratch *s=r->scratch;
    /* Four subpixel samples are enough for localization; they are NEVER used
     * as the image to crop/resize. Final pixels come from the native frame. */
    for(y=0;y<ph;++y) {
        for(x=0;x<pw;++x) {
            unsigned a,b,sum=0;
            for(b=0;b<2u;++b) for(a=0;a<2u;++a) {
                unsigned sx=(unsigned)(((uint64_t)(4u*x+1u+2u*a)*r->sw)/(4u*pw));
                unsigned sy=(unsigned)(((uint64_t)(4u*y+1u+2u*b)*r->sh)/(4u*ph));
                sx=smaller(sx,r->sw-1u); sy=smaller(sy,r->sh-1u);
                sum+=corrected_gray(r->color,r->source+(size_t)sy*r->source_stride+3u*sx);
            }
            s->preview[y*pw+x]=(uint8_t)((sum+2u)/4u);
        }
        if((y&15u)==15u) tick(r);
    }
    /* 3x3 binomial blur suppresses isolated print/noise without moving edges. */
    for(y=0;y<ph;++y) {
        for(x=0;x<pw;++x) {
            unsigned sum=0; int dy,dx;
            for(dy=-1;dy<=1;++dy) for(dx=-1;dx<=1;++dx) {
                unsigned weight=(dx==0?2u:1u)*(dy==0?2u:1u);
                sum+=weight*s->preview[(unsigned)clamp_index((int)y+dy,ph)*pw+
                                       (unsigned)clamp_index((int)x+dx,pw)];
            }
            s->smooth[y*pw+x]=(uint8_t)((sum+8u)/16u);
        }
        if((y&15u)==15u) tick(r);
    }
}

static void morphology(run_context *r, unsigned w, unsigned h, int dilate)
{
    binary_scratch *s=r->scratch;
    unsigned x,y;
    /* Separable 5x5 closing fills print strokes; four external edge tests
     * below prevent a printed staff rectangle from masquerading as paper. */
    for(y=0;y<h;++y) {
        for(x=0;x<w;++x) {
            unsigned v=dilate?0u:1u; int k;
            for(k=-2;k<=2;++k) {
                unsigned q=s->mask[y*w+(unsigned)clamp_index((int)x+k,w)];
                v=dilate?(v|q):(v&q);
            }
            s->temp[y*w+x]=(uint8_t)v;
        }
        if((y&15u)==15u) tick(r);
    }
    for(y=0;y<h;++y) {
        for(x=0;x<w;++x) {
            unsigned v=dilate?0u:1u; int k;
            for(k=-2;k<=2;++k) {
                unsigned q=s->temp[(unsigned)clamp_index((int)y+k,h)*w+x];
                v=dilate?(v|q):(v&q);
            }
            s->mask[y*w+x]=(uint8_t)v;
        }
        if((y&15u)==15u) tick(r);
    }
}

static unsigned convex_hull(binary_scratch *s, unsigned n)
{
    unsigned i,k=0,t;
    qsort(s->points,n,sizeof(point),compare_point);
    for(i=0;i<n;++i) {
        while(k>=2u && cross(s->hull[k-2u],s->hull[k-1u],s->points[i])<=0.0) --k;
        s->hull[k++]=s->points[i];
    }
    t=k+1u;
    for(i=n-1u;i>0u;--i) {
        while(k>=t && cross(s->hull[k-2u],s->hull[k-1u],s->points[i-1u])<=0.0) --k;
        s->hull[k++]=s->points[i-1u];
    }
    return k>1u?k-1u:0u;
}
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
