FranzVanChopin/ac920-score-digitizer/(commit log)

2026-11-03 AC920 乐谱数字化与播放系统：拍照采集 + v16 识别 + DP 播放（MIT）
2026-11-03 并入脱敏补充材料：技能包、协作摘要、FPGA 报告溯源
    [storyboard.csv]
2026-11-03 修正 skill/validate_skills.py 样本路径：识别证据重组后位于 board/recognition/
2026-11-04 移除个人与团队署名：README 删除作者小节，LICENSE 改为集体署名
